Chanevan317/Mobile-Manipulator-Robot/README.md

# Mobile-Manipulator-Robot

A wheeled mobile manipulator for restocking retail shelves: a mecanum base, a C-Beam lift and 3D-printed SCARA
arms (STS3215 servos), with a small leader arm for teleoperation. Work in progress: the arms are being printed, and
the robot is tested in simulation (Isaac Sim, ROS 2).

robot

## Folders

| Folder | What |
|---|---|
| `CAD/SCARA_arm/` | the follower arm: print files, STEP, assembly, fastener lists |
| `CAD/dual_holder/` | two-arm robot: printed holder for both arm bases on the C-Beam carriage (and the scene camera post) |
| `CAD/mono_ring/` | shoulder ring for the one-arm version: the arm's own base on a shelf on the ring, 2 bought 6820-2RS bearings |
| `CAD/leader_arm/` | the leader arm for teleoperation |
| `CAD/lift_stick/` | one-hand controller for the lift: thumbstick, dead-man and stored-position buttons |
| `mobile_manipulator_description/` | the robot model (URDF, meshes), the CAD generator and the simulation scripts |

Large files (STL, STEP, PNG, ...) are stored with Git LFS: run `git lfs install` before cloning.
