Chanevan317/Mobile-Manipulator-Robot/CAD/lift_stick/parts.csv

file | qty | size_mm | volume_cm3 | note
S1_stick_tray.stl | 1 | 116.0 x 42.0 x 15.5 | 23.3 | bottom tray: the Pico slide-in mount (room for headers), holes for 2 optional M2 screws, USB opening, 4 countersunk M2.5 from underneath, 4 rubber-feet recesses; prints flat
S2_stick_top.stl | 1 | 116.0 x 42.0 x 34.0 | 26.6 | top shell (the grip): round stick hole + "up" arrow on the head, 4 posts for the joystick bracket, 2 button holes with guide sleeves + 2 bracket posts on the front, 2 fins that stop the Pico; prints upside down (head top on the bed, tree supports under the sloping tail)
S3_stick_bracket.stl | 1 | 44.0 x 28.0 x 5.4 | 2.6 | holds the joystick module (4 standoffs, M2.5 x 8 self-tap from above through its holes); screws up into the top shell (4 x M2 x 8); prints flat
S4_button_bracket.stl | 1 | 28.4 x 36.4 x 5.6 | 4.5 | OPTIONAL, print with the buttons: holds both 12 x 12 tactile switches (pockets to the front, leg slots behind); 2 x M2 x 10 into the posts on the front wall; prints on its back
S5_button_cap.stl | 2 | 12.9 x 26.8 x 9.2 | 2.3 | OPTIONAL, print 2 with the buttons: button cap, sticks out 3 mm; drop it in from inside before the bracket (the flange keeps it in); prints flange down
