Chanevan317/Mobile-Manipulator-Robot/CAD/SCARA_arm/fasteners_by_location.csv

# | goes in part | type | size | length_mm | purpose | x_part | y_part | z_part | dir_x | dir_y | dir_z | x_arm | y_arm | z_arm
1 | base_top | SHCS | M3 | 35 | clamshell | -41.50 | -16.30 | 29.00 | 0.000 | 0.000 | -1.000 | -41.50 | -16.30 | 29.00
2 | base_top | SHCS | M3 | 35 | clamshell | -41.50 | 16.30 | 29.00 | 0.000 | 0.000 | -1.000 | -41.50 | 16.30 | 29.00
3 | base_top | SHCS | M3 | 35 | clamshell | 27.81 | -14.79 | 29.00 | 0.000 | 0.000 | -1.000 | 27.81 | -14.79 | 29.00
4 | base_top | SHCS | M3 | 35 | clamshell | 27.81 | 14.79 | 29.00 | 0.000 | 0.000 | -1.000 | 27.81 | 14.79 | 29.00
5 | base_top | selftap | M2 | 6 | servo case (SO-100) | -32.80 | 10.25 | 17.90 | 0.000 | 0.000 | -1.000 | -32.80 | 10.25 | 17.90
6 | base_top | selftap | M2 | 6 | servo case (SO-100) | -32.80 | -10.25 | 17.90 | 0.000 | 0.000 | -1.000 | -32.80 | -10.25 | 17.90
7 | base_top | SHCS | M3 | 35 | clamshell | -74.00 | -14.50 | 29.00 | 0.000 | 0.000 | -1.000 | -74.00 | -14.50 | 29.00
8 | base_top | SHCS | M3 | 35 | clamshell | -74.00 | 14.50 | 29.00 | 0.000 | 0.000 | -1.000 | -74.00 | 14.50 | 29.00
9 | base_bottom | insert | M3 | 8 | clamshell | -41.50 | -16.30 | 0.00 | 0.000 | 0.000 | -1.000 | -41.50 | -16.30 | 0.00
10 | base_bottom | insert | M3 | 8 | clamshell | -41.50 | 16.30 | 0.00 | 0.000 | 0.000 | -1.000 | -41.50 | 16.30 | 0.00
11 | base_bottom | insert | M3 | 8 | clamshell | 27.81 | -14.79 | 0.00 | 0.000 | 0.000 | -1.000 | 27.81 | -14.79 | 0.00
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
112 | camera_cradle | selftap | M2 | 8 | camera board (from the front, into the standoff) | 106.14 | -14.00 | 112.29 | -0.819 | 0.000 | 0.574 | 406.14 | -14.00 | 37.69
113 | camera_cradle | selftap | M2 | 8 | camera board (from the front, into the standoff) | 90.08 | 14.00 | 89.35 | -0.819 | 0.000 | 0.574 | 390.08 | 14.00 | 14.75
114 | camera_cradle | selftap | M2 | 8 | camera board (from the front, into the standoff) | 106.14 | 14.00 | 112.29 | -0.819 | 0.000 | 0.574 | 406.14 | 14.00 | 37.69
115 | roll_yoke_gripper_housing | SHCS | M3 | 10 | roll horn | 25.60 | -4.95 | 4.95 | -1.000 | 0.000 | 0.000 | 410.60 | -4.95 | -69.65
116 | roll_yoke_gripper_housing | SHCS | M3 | 10 | roll horn | 25.60 | 4.95 | 4.95 | -1.000 | 0.000 | 0.000 | 410.60 | 4.95 | -69.65
117 | roll_yoke_gripper_housing | SHCS | M3 | 10 | roll horn | 25.60 | -4.95 | -4.95 | -1.000 | 0.000 | 0.000 | 410.60 | -4.95 | -79.55
118 | roll_yoke_gripper_housing | SHCS | M3 | 10 | roll horn | 25.60 | 4.95 | -4.95 | -1.000 | 0.000 | 0.000 | 410.60 | 4.95 | -79.55
119 | roll_yoke_gripper_housing | selftap | M2 | 6 | gripper servo case (SO-100) | 31.10 | -10.25 | 32.80 | 1.000 | 0.000 | 0.000 | 416.10 | -10.25 | -41.80
120 | roll_yoke_gripper_housing | selftap | M2 | 6 | gripper servo case (SO-100) | 31.10 | 10.25 | 32.80 | 1.000 | 0.000 | 0.000 | 416.10 | 10.25 | -41.80
121 | roll_yoke_gripper_housing | insert | M3 | 4 | gripper front plate | 66.00 | -16.10 | -8.00 | -1.000 | 0.000 | 0.000 | 451.00 | -16.10 | -82.60
122 | roll_yoke_gripper_housing | insert | M3 | 4 | gripper front plate | 66.00 | -16.10 | 30.00 | -1.000 | 0.000 | 0.000 | 451.00 | -16.10 | -44.60
123 | roll_yoke_gripper_housing | insert | M3 | 4 | gripper front plate | 66.00 | 16.10 | -8.00 | -1.000 | 0.000 | 0.000 | 451.00 | 16.10 | -82.60
124 | roll_yoke_gripper_housing | insert | M3 | 4 | gripper front plate | 66.00 | 16.10 | 30.00 | -1.000 | 0.000 | 0.000 | 451.00 | 16.10 | -44.60
125 | gripper_front_plate | SHCS | M3 | 10 | front plate to housing | 71.00 | -16.10 | -8.00 | -1.000 | 0.000 | 0.000 | 456.00 | -16.10 | -82.60
126 | gripper_front_plate | SHCS | M3 | 10 | front plate to housing | 71.00 | -16.10 | 30.00 | -1.000 | 0.000 | 0.000 | 456.00 | -16.10 | -44.60
127 | gripper_front_plate | SHCS | M3 | 10 | front plate to housing | 71.00 | 16.10 | -8.00 | -1.000 | 0.000 | 0.000 | 456.00 | 16.10 | -82.60
128 | gripper_front_plate | SHCS | M3 | 10 | front plate to housing | 71.00 | 16.10 | 30.00 | -1.000 | 0.000 | 0.000 | 456.00 | 16.10 | -44.60
129 | gripper_front_plate | SHCS | M3 | 12 | MGN9 rail | 77.00 | -80.00 | 32.00 | -1.000 | 0.000 | 0.000 | 462.00 | -80.00 | -42.60
130 | gripper_front_plate | nut | M3 |  | MGN9 rail (nut trap) | 66.00 | -80.00 | 32.00 | 1.000 | 0.000 | 0.000 | 451.00 | -80.00 | -42.60
131 | gripper_front_plate | SHCS | M3 | 12 | MGN9 rail | 77.00 | -60.00 | 32.00 | -1.000 | 0.000 | 0.000 | 462.00 | -60.00 | -42.60
132 | gripper_front_plate | nut | M3 |  | MGN9 rail (nut trap) | 66.00 | -60.00 | 32.00 | 1.000 | 0.000 | 0.000 | 451.00 | -60.00 | -42.60
133 | gripper_front_plate | SHCS | M3 | 12 | MGN9 rail | 77.00 | -40.00 | 32.00 | -1.000 | 0.000 | 0.000 | 462.00 | -40.00 | -42.60
134 | gripper_front_plate | nut | M3 |  | MGN9 rail (nut trap) | 66.00 | -40.00 | 32.00 | 1.000 | 0.000 | 0.000 | 451.00 | -40.00 | -42.60
135 | gripper_front_plate | SHCS | M3 | 12 | MGN9 rail | 77.00 | 40.00 | 32.00 | -1.000 | 0.000 | 0.000 | 462.00 | 40.00 | -42.60
136 | gripper_front_plate | nut | M3 |  | MGN9 rail (nut trap) | 66.00 | 40.00 | 32.00 | 1.000 | 0.000 | 0.000 | 451.00 | 40.00 | -42.60
137 | gripper_front_plate | SHCS | M3 | 12 | MGN9 rail | 77.00 | 60.00 | 32.00 | -1.000 | 0.000 | 0.000 | 462.00 | 60.00 | -42.60
138 | gripper_front_plate | nut | M3 |  | MGN9 rail (nut trap) | 66.00 | 60.00 | 32.00 | 1.000 | 0.000 | 0.000 | 451.00 | 60.00 | -42.60
139 | gripper_front_plate | SHCS | M3 | 12 | MGN9 rail | 77.00 | 80.00 | 32.00 | -1.000 | 0.000 | 0.000 | 462.00 | 80.00 | -42.60
140 | gripper_front_plate | nut | M3 |  | MGN9 rail (nut trap) | 66.00 | 80.00 | 32.00 | 1.000 | 0.000 | 0.000 | 451.00 | 80.00 | -42.60
141 | pinion_24T_m1 | SHCS | M3 | 10 | pinion to gripper horn | -4.95 | -4.95 | 75.60 | 0.000 | 0.000 | -1.000 | 460.60 | 1.00 | -81.53
142 | pinion_24T_m1 | SHCS | M3 | 10 | pinion to gripper horn | -4.95 | 4.95 | 75.60 | 0.000 | 0.000 | -1.000 | 460.60 | -6.93 | -75.60
143 | pinion_24T_m1 | SHCS | M3 | 10 | pinion to gripper horn | 4.95 | -4.95 | 75.60 | 0.000 | 0.000 | -1.000 | 460.60 | 6.93 | -73.60
144 | pinion_24T_m1 | SHCS | M3 | 10 | pinion to gripper horn | 4.95 | 4.95 | 75.60 | 0.000 | 0.000 | -1.000 | 460.60 | -1.00 | -67.67
145 | finger_carrier_right | SHCS | M3 | 8 | carrier to MGN9H | 89.00 | 12.50 | 24.50 | -1.000 | 0.000 | 0.000 | 474.00 | 42.50 | -50.10
146 | finger_carrier_right | SHCS | M3 | 8 | carrier to MGN9H | 89.00 | 12.50 | 39.50 | -1.000 | 0.000 | 0.000 | 474.00 | 42.50 | -35.10
147 | finger_carrier_right | SHCS | M3 | 8 | carrier to MGN9H | 89.00 | 28.50 | 24.50 | -1.000 | 0.000 | 0.000 | 474.00 | 58.50 | -50.10
148 | finger_carrier_right | SHCS | M3 | 8 | carrier to MGN9H | 89.00 | 28.50 | 39.50 | -1.000 | 0.000 | 0.000 | 474.00 | 58.50 | -35.10
149 | finger_carrier_right | SHCS | M3 | 10 | finger | 87.00 | 7.00 | -10.00 | 1.000 | 0.000 | 0.000 | 472.00 | 37.00 | -84.60
150 | finger_carrier_right | SHCS | M3 | 10 | finger | 87.00 | 7.00 | 10.00 | 1.000 | 0.000 | 0.000 | 472.00 | 37.00 | -64.60
151 | finger_carrier_left | SHCS | M3 | 8 | carrier to MGN9H | 89.00 | -12.50 | 24.50 | -1.000 | 0.000 | 0.000 | 474.00 | -42.50 | -50.10
152 | finger_carrier_left | SHCS | M3 | 8 | carrier to MGN9H | 89.00 | -12.50 | 39.50 | -1.000 | 0.000 | 0.000 | 474.00 | -42.50 | -35.10
153 | finger_carrier_left | SHCS | M3 | 8 | carrier to MGN9H | 89.00 | -28.50 | 24.50 | -1.000 | 0.000 | 0.000 | 474.00 | -58.50 | -50.10
154 | finger_carrier_left | SHCS | M3 | 8 | carrier to MGN9H | 89.00 | -28.50 | 39.50 | -1.000 | 0.000 | 0.000 | 474.00 | -58.50 | -35.10
155 | finger_carrier_left | SHCS | M3 | 10 | finger | 87.00 | -7.00 | -10.00 | 1.000 | 0.000 | 0.000 | 472.00 | -37.00 | -84.60
156 | finger_carrier_left | SHCS | M3 | 10 | finger | 87.00 | -7.00 | 10.00 | 1.000 | 0.000 | 0.000 | 472.00 | -37.00 | -64.60
157 | finger_right | insert | M3 | 6 | finger | 92.00 | 7.00 | -10.00 | 1.000 | 0.000 | 0.000 | 477.00 | 37.00 | -84.60
158 | finger_right | insert | M3 | 6 | finger | 92.00 | 7.00 | 10.00 | 1.000 | 0.000 | 0.000 | 477.00 | 37.00 | -64.60
159 | finger_left | insert | M3 | 6 | finger | 92.00 | -7.00 | -10.00 | 1.000 | 0.000 | 0.000 | 477.00 | -37.00 | -84.60
160 | finger_left | insert | M3 | 6 | finger | 92.00 | -7.00 | 10.00 | 1.000 | 0.000 | 0.000 | 477.00 | -37.00 | -64.60
