Chanevan317/Mobile-Manipulator-Robot/(list of files, cad)

Other CAD files:
CAD/SCARA_arm/SCARA_arm_assembly.3mf
CAD/SCARA_arm/step/SCARA_arm_printed_parts_assembly.step
CAD/dual_holder/assembly_stl/context/arm_bases_01_02.stl
CAD/dual_holder/assembly_stl/D01_holder_left.stl
CAD/dual_holder/print_ready_stl/D01_holder_left.stl
CAD/leader_arm/assembly_stl/mono/mono_foot.stl
CAD/leader_arm/assembly_stl/proto/L_S2_elbow.stl
CAD/leader_arm/print_ready_stl/03_link2.stl
CAD/lift_stick/assembly_stl/S2_stick_top.stl
CAD/lift_stick/print_ready_stl/S5_button_cap.stl
CAD/mono_ring/assembly_stl/context/arm_base_01_02_with_shoulder_servo.stl
CAD/mono_ring/assembly_stl/M04_gantry_bracket.stl
CAD/mono_ring/print_ready_stl/M08_board_mount.stl
CAD/SCARA_arm/assembly_stl/14_roll_yoke_gripper_housing.stl
CAD/SCARA_arm/print_ready_stl/14_roll_yoke_gripper_housing.stl
CAD/SCARA_arm/SO100/WaveShare_Mounting_Plate_SO101.stl
mobile_manipulator_description/generator/cbeam/carriage.stl
mobile_manipulator_description/generator/sts3215_03a_v1.stl
mobile_manipulator_description/meshes/collision/dual_holder_right_c31.stl
mobile_manipulator_description/meshes/visual/dual_holder_left.stl
CAD/dual_holder/assembly_stl/context/camera_post.stl
CAD/dual_holder/assembly_stl/D02_holder_right.stl
CAD/dual_holder/print_ready_stl/D02_holder_right.stl
CAD/leader_arm/assembly_stl/mono/pedestal.stl
CAD/leader_arm/assembly_stl/proto/R_pedestal.stl
CAD/leader_arm/print_ready_stl/08_gripper_jaw.stl
CAD/lift_stick/assembly_stl/S3_stick_bracket.stl
CAD/lift_stick/print_ready_stl/S3_stick_bracket.stl
CAD/mono_ring/assembly_stl/context/bearings_61820.stl
CAD/mono_ring/assembly_stl/M01_ring_base.stl
CAD/mono_ring/print_ready_stl/M02_inner_spacer.stl
CAD/SCARA_arm/assembly_stl/17_finger_carrier_right.stl
CAD/SCARA_arm/print_ready_stl/22_insert_test_block.stl
CAD/SCARA_arm/SO100/Print_Leader_SO_ARM100_08k_UP_BambuLabA1Mini_part1.STL
CAD/SCARA_arm/step/SCARA_arm_purchased_parts.step
mobile_manipulator_description/generator/cbeam/column_hw.stl
mobile_manipulator_description/meshes/collision/dual_holder_left_c13.stl
mobile_manipulator_description/meshes/visual/dual_holder_right.stl
CAD/dual_holder/assembly_stl/context/lift_kit_gantry_wheels_beam.stl
CAD/leader_arm/assembly_stl/mono/pitch_fork.stl
CAD/leader_arm/assembly_stl/proto/L_pedestal.stl
CAD/leader_arm/print_ready_stl/11_proto_foot_left.stl
CAD/lift_stick/assembly_stl/S4_button_bracket.stl
CAD/lift_stick/print_ready_stl/S4_button_bracket.stl
CAD/mono_ring/assembly_stl/context/drive_servo_STS3215.stl
CAD/mono_ring/assembly_stl/M10_cable_tray.stl
CAD/mono_ring/print_ready_stl/M03_clamp_ring.stl
CAD/SCARA_arm/assembly_stl/12_tilt_fork_idler.stl
CAD/SCARA_arm/print_ready_stl/16_pinion_24T_m1.stl
CAD/SCARA_arm/SO100/Print_Leader_SO_ARM100_08k_UP_BambuLabA1Mini_part2.STL
mobile_manipulator_description/generator/cbeam/motor.stl
mobile_manipulator_description/meshes/collision/dual_holder_left_c42.stl
mobile_manipulator_description/meshes/visual/mono_bearing_2_inner.stl
CAD/leader_arm/assembly_stl/mono/link2.stl
CAD/leader_arm/assembly_stl/proto/R_S4_pitch.stl
CAD/leader_arm/print_ready_stl/05_pitch_fork.stl
CAD/lift_stick/assembly_stl/S5_button_cap.stl
CAD/lift_stick/print_ready_stl/S2_stick_top.stl
CAD/mono_ring/assembly_stl/context/servo_board_on_SO101_plate.stl
CAD/mono_ring/assembly_stl/M08_board_mount.stl
CAD/mono_ring/print_ready_stl/M04_gantry_bracket.stl
CAD/SCARA_arm/assembly_stl/20_finger_left.stl
CAD/SCARA_arm/print_ready_stl/04_upper_arm_bottom.stl
mobile_manipulator_description/generator/cbeam/top.stl
mobile_manipulator_description/meshes/collision/dual_holder_right_c08.stl
mobile_manipulator_description/meshes/visual/mono_servo_board.stl
CAD/leader_arm/assembly_stl/mono/wrist.stl
CAD/leader_arm/assembly_stl/proto/R_shoulder_mount.stl
CAD/leader_arm/print_ready_stl/10_mono_foot.stl
CAD/lift_stick/assembly_stl/boards_assumed.stl
CAD/lift_stick/print_ready_stl/S1_stick_tray.stl
CAD/mono_ring/assembly_stl/M03_clamp_ring.stl
CAD/mono_ring/print_ready_stl/M01_ring_base.stl
CAD/SCARA_arm/assembly_stl/01_base_top.stl
CAD/SCARA_arm/print_ready_stl/17_finger_carrier_right.stl
mobile_manipulator_description/generator/cbeam/beam.stl
mobile_manipulator_description/meshes/collision/dual_holder_right_c57.stl
mobile_manipulator_description/meshes/visual/mono_bearing_2_outer.stl
CAD/leader_arm/assembly_stl/mono/gripper_fixed_jaw.stl
CAD/leader_arm/assembly_stl/proto/L_S4_pitch.stl
CAD/leader_arm/print_ready_stl/07_gripper_fixed_jaw.stl
CAD/lift_stick/assembly_stl/S1_stick_tray.stl
CAD/mono_ring/assembly_stl/M02_inner_spacer.stl
CAD/mono_ring/print_ready_stl/M10_cable_tray.stl
CAD/SCARA_arm/assembly_stl/06_forearm_bottom.stl
CAD/SCARA_arm/print_ready_stl/13_camera_cradle.stl
mobile_manipulator_description/meshes/collision/dual_holder_right_c18.stl
mobile_manipulator_description/meshes/visual/mono_ring_base.stl
CAD/leader_arm/assembly_stl/mono/S5_roll.stl
CAD/leader_arm/assembly_stl/proto/L_S6_gripper.stl
CAD/leader_arm/print_ready_stl/04_wrist.stl
CAD/mono_ring/assembly_stl/M09_rotor.stl
CAD/mono_ring/print_ready_stl/M09_rotor.stl
CAD/SCARA_arm/assembly_stl/05_forearm_top.stl
CAD/SCARA_arm/print_ready_stl/01_base_top.stl
mobile_manipulator_description/meshes/collision/dual_holder_right_c35.stl
mobile_manipulator_description/meshes/visual/mono_ring_drive_STS3215.stl
CAD/leader_arm/assembly_stl/mono/S4_pitch.stl
CAD/leader_arm/assembly_stl/proto/R_gripper_frame.stl
CAD/leader_arm/print_ready_stl/09_pedestal.stl
CAD/mono_ring/assembly_stl/M06_drive_strap.stl
CAD/mono_ring/print_ready_stl/M07_ring_pinion.stl
CAD/SCARA_arm/assembly_stl/10_pitch_housing_idler.stl
CAD/SCARA_arm/print_ready_stl/03_upper_arm_top.stl
mobile_manipulator_description/meshes/collision/dual_holder_right_c24.stl
mobile_manipulator_description/meshes/visual/mono_rotor.stl
CAD/leader_arm/assembly_stl/mono/S2_elbow.stl
CAD/leader_arm/assembly_stl/proto/L_gripper_jaw.stl
CAD/leader_arm/print_ready_stl/02_link1.stl
CAD/mono_ring/assembly_stl/M05_drive_mount.stl
CAD/mono_ring/print_ready_stl/M05_drive_mount.stl
CAD/SCARA_arm/assembly_stl/18_finger_carrier_left.stl
CAD/SCARA_arm/print_ready_stl/10_pitch_housing_idler.stl
mobile_manipulator_description/meshes/collision/dual_holder_right_c49.stl
mobile_manipulator_description/meshes/visual/mono_board_mount.stl
CAD/leader_arm/assembly_stl/mono/S3_wrist_pan.stl
CAD/leader_arm/assembly_stl/proto/L_wrist.stl
CAD/leader_arm/print_ready_stl/01_shoulder_mount.stl
CAD/mono_ring/assembly_stl/M07_ring_pinion.stl
CAD/mono_ring/print_ready_stl/M06_drive_strap.stl
CAD/SCARA_arm/assembly_stl/07_wrist_top.stl
CAD/SCARA_arm/print_ready_stl/12_tilt_fork_idler.stl
mobile_manipulator_description/meshes/collision/dual_holder_left_c29.stl
mobile_manipulator_description/meshes/visual/arm_roll_yoke_gripper_housing.stl
CAD/leader_arm/assembly_stl/mono/shoulder_mount.stl
CAD/leader_arm/assembly_stl/proto/L_S3_wrist_pan.stl
CAD/leader_arm/print_ready_stl/12_proto_foot_right.stl
CAD/SCARA_arm/assembly_stl/19_finger_right.stl
CAD/SCARA_arm/print_ready_stl/19_finger_right.stl
mobile_manipulator_description/meshes/collision/dual_holder_right_c21.stl
mobile_manipulator_description/meshes/visual/mono_drive_strap.stl
CAD/leader_arm/assembly_stl/mono/gripper_jaw.stl
CAD/leader_arm/assembly_stl/proto/R_gripper_fixed_jaw.stl
CAD/leader_arm/print_ready_stl/06_gripper_frame.stl
CAD/SCARA_arm/assembly_stl/08_wrist_bottom.stl
CAD/SCARA_arm/print_ready_stl/08_wrist_bottom.stl
mobile_manipulator_description/meshes/collision/dual_holder_right_c27.stl
mobile_manipulator_description/meshes/visual/mono_drive_mount.stl
CAD/leader_arm/assembly_stl/mono/S6_gripper.stl
CAD/leader_arm/assembly_stl/proto/proto_foot_left.stl
CAD/SCARA_arm/assembly_stl/03_upper_arm_top.stl
CAD/SCARA_arm/print_ready_stl/02_base_bottom.stl
mobile_manipulator_description/meshes/collision/dual_holder_right_c52.stl
mobile_manipulator_description/meshes/visual/mono_cable_tray.stl
CAD/leader_arm/assembly_stl/mono/S1_shoulder.stl
CAD/leader_arm/assembly_stl/proto/L_S1_shoulder.stl
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
