Chanevan317/Mobile-Manipulator-Robot/mobile_manipulator_description/joint_test_report.csv

joint | unit | limit_lo | limit_hi | reached_lo | reached_hi | max_tracking_error | final_error | status
lift | mm | 0.0 | 871.0 | 0.0 | 870.5 | 1.53 | 0.0 | OK
left_shoulder_pan | deg | -115.0 | 115.0 | -115.0 | 115.0 | 6.87 | 0.07 | OK
right_shoulder_pan | deg | -115.0 | 115.0 | -115.0 | 115.0 | 6.87 | 0.07 | OK
left_elbow_pan | deg | -125.0 | 125.0 | -125.0 | 125.0 | 7.27 | 0.05 | OK
right_elbow_pan | deg | -125.0 | 125.0 | -125.0 | 125.0 | 7.27 | 0.05 | OK
left_wrist_pan | deg | -122.0 | 122.0 | -122.0 | 122.0 | 7.04 | 0.01 | OK
right_wrist_pan | deg | -122.0 | 122.0 | -122.0 | 122.0 | 7.04 | 0.01 | OK
left_wrist_pitch | deg | -15.0 | 115.0 | -13.3 | 114.6 | 5.11 | 1.81 | OK
right_wrist_pitch | deg | -15.0 | 115.0 | -13.3 | 114.6 | 5.11 | 1.81 | OK
left_wrist_roll | deg | -120.0 | 120.0 | -120.0 | 120.0 | 7.02 | 0.0 | OK
right_wrist_roll | deg | -120.0 | 120.0 | -120.0 | 120.0 | 7.02 | 0.0 | OK
left_finger_right | mm | 0.0 | 45.0 | 0.0 | 45.0 | 1.89 | 0.0 | OK
right_finger_right | mm | 0.0 | 45.0 | 0.0 | 45.0 | 1.89 | 0.0 | OK
