Chanevan317/Mobile-Manipulator-Robot/mobile_manipulator_description/reach_test_prototype.csv

surface | height_m | x_m | y_m | left | right
table | 0.75 | 0.315 | -0.45 | 0 | 0
table | 0.75 | 0.315 | -0.42 | 0 | 0
table | 0.75 | 0.315 | -0.39 | 0 | 1
table | 0.75 | 0.315 | -0.36 | 0 | 1
table | 0.75 | 0.315 | -0.33 | 0 | 1
table | 0.75 | 0.315 | -0.3 | 0 | 1
table | 0.75 | 0.315 | -0.27 | 0 | 1
table | 0.75 | 0.315 | -0.24 | 0 | 1
table | 0.75 | 0.315 | -0.21 | 0 | 1
table | 0.75 | 0.315 | -0.18 | 0 | 1
table | 0.75 | 0.315 | -0.15 | 0 | 1
table | 0.75 | 0.315 | -0.12 | 0 | 1
table | 0.75 | 0.315 | -0.09 | 0 | 1
table | 0.75 | 0.315 | -0.06 | 0 | 1
table | 0.75 | 0.315 | -0.03 | 0 | 0
table | 0.75 | 0.315 | -0.0 | 0 | 0
table | 0.75 | 0.315 | 0.03 | 0 | 0
table | 0.75 | 0.315 | 0.06 | 1 | 0
table | 0.75 | 0.315 | 0.09 | 1 | 0
table | 0.75 | 0.315 | 0.12 | 1 | 0
table | 0.75 | 0.315 | 0.15 | 1 | 0
table | 0.75 | 0.315 | 0.18 | 1 | 0
table | 0.75 | 0.315 | 0.21 | 1 | 0
table | 0.75 | 0.315 | 0.24 | 1 | 0
table | 0.75 | 0.315 | 0.27 | 1 | 0
table | 0.75 | 0.315 | 0.3 | 1 | 0
table | 0.75 | 0.315 | 0.33 | 1 | 0
table | 0.75 | 0.315 | 0.36 | 1 | 0
table | 0.75 | 0.315 | 0.39 | 1 | 0
table | 0.75 | 0.315 | 0.42 | 0 | 0
table | 0.75 | 0.315 | 0.45 | 0 | 0
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
