Chanevan317/Mobile-Manipulator-Robot/mobile_manipulator_description/urdf/mobile_manipulator_prototype.urdf

<?xml version="1.0" encoding="utf-8"?>
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
<robot name="mobile_manipulator">
  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
  <link name="base_link">
    <inertial><origin xyz="0 0 0" rpy="0 0 0"/><mass value="0.001"/>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</inertial>
  </link>
  <link name="base_body">
    <inertial><origin xyz="0 0 0.113947" rpy="0 0 0"/><mass value="19"/>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</inertial>
    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
  </link>
  <joint name="base_body_fixed" type="fixed"><parent link="base_link"/><child link="base_body"/><origin xyz="0 0 0" rpy="0 0 0"/></joint>
  <link name="wheel_fl">
    <inertial><origin xyz="0 0 0" rpy="0 0 0"/><mass value="0.3"/>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</inertial>
    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
  </link>
  <joint name="wheel_fl_joint" type="continuous"><parent link="base_link"/><child link="wheel_fl"/><origin xyz="0.17 0.222 0.05" rpy="0 0 0"/><axis xyz="0 1 0"/><limit lower="-1e+09" upper="1e+09" effort="6" velocity="25"/><dynamics damping="0.1" friction="0.05"/></joint>
  <link name="wheel_fl_roller_0">
    <inertial><origin xyz="0 0 0" rpy="0 0 0"/><mass value="0.012"/>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</inertial>
    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
  </link>
  <joint name="wheel_fl_roller_0_joint" type="continuous"><parent link="wheel_fl"/><child link="wheel_fl_roller_0"/><origin xyz="0 0 0.039" rpy="-1.5708 0.785398 -0.785398"/><axis xyz="0 0 1"/><limit lower="-1e+09" upper="1e+09" effort="0" velocity="200"/><dynamics damping="0.0005" friction="0"/></joint>
  <link name="wheel_fl_roller_1">
    <inertial><origin xyz="0 0 0" rpy="0 0 0"/><mass value="0.012"/>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</inertial>
    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
  </link>
  <joint name="wheel_fl_roller_1_joint" type="continuous"><parent link="wheel_fl"/><child link="wheel_fl_roller_1"/><origin xyz="0.0250687 0 0.0298757" rpy="-2.14208 0.572429 -0.988745"/><axis xyz="0 0 1"/><limit lower="-1e+09" upper="1e+09" effort="0" velocity="200"/><dynamics damping="0.0005" friction="0"/></joint>
  <link name="wheel_fl_roller_2">
    <inertial><origin xyz="0 0 0" rpy="0 0 0"/><mass value="0.012"/>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</inertial>
    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
  </link>
  <joint name="wheel_fl_roller_2_joint" type="continuous"><parent link="wheel_fl"/><child link="wheel_fl_roller_2"/><origin xyz="0.0384075 0 0.00677228" rpy="-2.34854 0.123098 -0.292272"/><axis xyz="0 0 1"/><limit lower="-1e+09" upper="1e+09" effort="0" velocity="200"/><dynamics damping="0.0005" friction="0"/></joint>
  <link name="wheel_fl_roller_3">
    <inertial><origin xyz="0 0 0" rpy="0 0 0"/><mass value="0.012"/>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</inertial>
    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
  </link>
  <joint name="wheel_fl_roller_3_joint" type="continuous"><parent link="wheel_fl"/><child link="wheel_fl_roller_3"/><origin xyz="0.033775 0 -0.0195" rpy="-2.28452 -0.361367 0.76077"/><axis xyz="0 0 1"/><limit lower="-1e+09" upper="1e+09" effort="0" velocity="200"/><dynamics damping="0.0005" friction="0"/></joint>
  <link name="wheel_fl_roller_4">
    <inertial><origin xyz="0 0 0" rpy="0 0 0"/><mass value="0.012"/>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</inertial>
    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
  </link>
  <joint name="wheel_fl_roller_4_joint" type="continuous"><parent link="wheel_fl"/><child link="wheel_fl_roller_4"/><origin xyz="0.0133388 0 -0.036648" rpy="-1.90034 -0.726775 0.977781"/><axis xyz="0 0 1"/><limit lower="-1e+09" upper="1e+09" effort="0" velocity="200"/><dynamics damping="0.0005" friction="0"/></joint>
  <link name="wheel_fl_roller_5">
    <inertial><origin xyz="0 0 0" rpy="0 0 0"/><mass value="0.012"/>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</inertial>
    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
  </link>
  <joint name="wheel_fl_roller_5_joint" type="continuous"><parent link="wheel_fl"/><child link="wheel_fl_roller_5"/><origin xyz="-0.0133388 0 -0.036648" rpy="-1.24125 -0.726775 0.530853"/><axis xyz="0 0 1"/><limit lower="-1e+09" upper="1e+09" effort="0" velocity="200"/><dynamics damping="0.0005" friction="0"/></joint>
  <link name="wheel_fl_roller_6">
    <inertial><origin xyz="0 0 0" rpy="0 0 0"/><mass value="0.012"/>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</inertial>
    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
  </link>
  <joint name="wheel_fl_roller_6_joint" type="continuous"><parent link="wheel_fl"/><child link="wheel_fl_roller_6"/><origin xyz="-0.033775 0 -0.0195" rpy="-0.857072 -0.361367 0.166525"/><axis xyz="0 0 1"/><limit lower="-1e+09" upper="1e+09" effort="0" velocity="200"/><dynamics damping="0.0005" friction="0"/></joint>
  <link name="wheel_fl_roller_7">
    <inertial><origin xyz="0 0 0" rpy="0 0 0"/><mass value="0.012"/>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</inertial>
    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
  </link>
  <joint name="wheel_fl_roller_7_joint" type="continuous"><parent link="wheel_fl"/><child link="wheel_fl_roller_7"/><origin xyz="-0.0384075 0 0.00677228" rpy="-0.793052 0.123098 -0.0515956"/><axis xyz="0 0 1"/><limit lower="-1e+09" upper="1e+09" effort="0" velocity="200"/><dynamics damping="0.0005" friction="0"/></joint>
  <link name="wheel_fl_roller_8">
    <inertial><origin xyz="0 0 0" rpy="0 0 0"/><mass value="0.012"/>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</inertial>
    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
  </link>
  <joint name="wheel_fl_roller_8_joint" type="continuous"><parent link="wheel_fl"/><child link="wheel_fl_roller_8"/><origin xyz="-0.0250687 0 0.0298757" rpy="-0.999508 0.572429 -0.318636"/><axis xyz="0 0 1"/><limit lower="-1e+09" upper="1e+09" effort="0" velocity="200"/><dynamics damping="0.0005" friction="0"/></joint>
  <link name="wheel_fr">
    <inertial><origin xyz="0 0 0" rpy="0 0 0"/><mass value="0.3"/>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</inertial>
    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
  </link>
  <joint name="wheel_fr_joint" type="continuous"><parent link="base_link"/><child link="wheel_fr"/><origin xyz="0.17 -0.222 0.05" rpy="0 0 0"/><axis xyz="0 1 0"/><limit lower="-1e+09" upper="1e+09" effort="6" velocity="25"/><dynamics damping="0.1" friction="0.05"/></joint>
  <link name="wheel_fr_roller_0">
    <inertial><origin xyz="0 0 0" rpy="0 0 0"/><mass value="0.012"/>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</inertial>
    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
  </link>
  <joint name="wheel_fr_roller_0_joint" type="continuous"><parent link="wheel_fr"/><child link="wheel_fr_roller_0"/><origin xyz="0 0 0.039" rpy="-1.5708 -0.785398 0.785398"/><axis xyz="0 0 1"/><limit lower="-1e+09" upper="1e+09" effort="0" velocity="200"/><dynamics damping="0.0005" friction="0"/></joint>
  <link name="wheel_fr_roller_1">
    <inertial><origin xyz="0 0 0" rpy="0 0 0"/><mass value="0.012"/>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</inertial>
    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
  </link>
  <joint name="wheel_fr_roller_1_joint" type="continuous"><parent link="wheel_fr"/><child link="wheel_fr_roller_1"/><origin xyz="0.0250687 0 0.0298757" rpy="-0.999508 -0.572429 0.318636"/><axis xyz="0 0 1"/><limit lower="-1e+09" upper="1e+09" effort="0" velocity="200"/><dynamics damping="0.0005" friction="0"/></joint>
  <link name="wheel_fr_roller_2">
    <inertial><origin xyz="0 0 0" rpy="0 0 0"/><mass value="0.012"/>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</inertial>
    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
  </link>
  <joint name="wheel_fr_roller_2_joint" type="continuous"><parent link="wheel_fr"/><child link="wheel_fr_roller_2"/><origin xyz="0.0384075 0 0.00677228" rpy="-0.793052 -0.123098 0.0515956"/><axis xyz="0 0 1"/><limit lower="-1e+09" upper="1e+09" effort="0" velocity="200"/><dynamics damping="0.0005" friction="0"/></joint>
  <link name="wheel_fr_roller_3">
    <inertial><origin xyz="0 0 0" rpy="0 0 0"/><mass value="0.012"/>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</inertial>
    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
  </link>
  <joint name="wheel_fr_roller_3_joint" type="continuous"><parent link="wheel_fr"/><child link="wheel_fr_roller_3"/><origin xyz="0.033775 0 -0.0195" rpy="-0.857072 0.361367 -0.166525"/><axis xyz="0 0 1"/><limit lower="-1e+09" upper="1e+09" effort="0" velocity="200"/><dynamics damping="0.0005" friction="0"/></joint>
  <link name="wheel_fr_roller_4">
    <inertial><origin xyz="0 0 0" rpy="0 0 0"/><mass value="0.012"/>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</inertial>
    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
  </link>
  <joint name="wheel_fr_roller_4_joint" type="continuous"><parent link="wheel_fr"/><child link="wheel_fr_roller_4"/><origin xyz="0.0133388 0 -0.036648" rpy="-1.24125 0.726775 -0.530853"/><axis xyz="0 0 1"/><limit lower="-1e+09" upper="1e+09" effort="0" velocity="200"/><dynamics damping="0.0005" friction="0"/></joint>
  <link name="wheel_fr_roller_5">
    <inertial><origin xyz="0 0 0" rpy="0 0 0"/><mass value="0.012"/>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</inertial>
    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
  </link>
  <joint name="wheel_fr_roller_5_joint" type="continuous"><parent link="wheel_fr"/><child link="wheel_fr_roller_5"/><origin xyz="-0.0133388 0 -0.036648" rpy="-1.90034 0.726775 -0.977781"/><axis xyz="0 0 1"/><limit lower="-1e+09" upper="1e+09" effort="0" velocity="200"/><dynamics damping="0.0005" friction="0"/></joint>
  <link name="wheel_fr_roller_6">
    <inertial><origin xyz="0 0 0" rpy="0 0 0"/><mass value="0.012"/>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</inertial>
    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
  </link>
  <joint name="wheel_fr_roller_6_joint" type="continuous"><parent link="wheel_fr"/><child link="wheel_fr_roller_6"/><origin xyz="-0.033775 0 -0.0195" rpy="-2.28452 0.361367 -0.76077"/><axis xyz="0 0 1"/><limit lower="-1e+09" upper="1e+09" effort="0" velocity="200"/><dynamics damping="0.0005" friction="0"/></joint>
  <link name="wheel_fr_roller_7">
    <inertial><origin xyz="0 0 0" rpy="0 0 0"/><mass value="0.012"/>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</inertial>
    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
  </link>
  <joint name="wheel_fr_roller_7_joint" type="continuous"><parent link="wheel_fr"/><child link="wheel_fr_roller_7"/><origin xyz="-0.0384075 0 0.00677228" rpy="-2.34854 -0.123098 0.292272"/><axis xyz="0 0 1"/><limit lower="-1e+09" upper="1e+09" effort="0" velocity="200"/><dynamics damping="0.0005" friction="0"/></joint>
  <link name="wheel_fr_roller_8">
    <inertial><origin xyz="0 0 0" rpy="0 0 0"/><mass value="0.012"/>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</inertial>
    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
  </link>
  <joint name="wheel_fr_roller_8_joint" type="continuous"><parent link="wheel_fr"/><child link="wheel_fr_roller_8"/><origin xyz="-0.0250687 0 0.0298757" rpy="-2.14208 -0.572429 0.988745"/><axis xyz="0 0 1"/><limit lower="-1e+09" upper="1e+09" effort="0" velocity="200"/><dynamics damping="0.0005" friction="0"/></joint>
  <link name="wheel_rl">
    <inertial><origin xyz="0 0 0" rpy="0 0 0"/><mass value="0.3"/>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</inertial>
    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
  </link>
  <joint name="wheel_rl_joint" type="continuous"><parent link="base_link"/><child link="wheel_rl"/><origin xyz="-0.17 0.222 0.05" rpy="0 0 0"/><axis xyz="0 1 0"/><limit lower="-1e+09" upper="1e+09" effort="6" velocity="25"/><dynamics damping="0.1" friction="0.05"/></joint>
  <link name="wheel_rl_roller_0">
    <inertial><origin xyz="0 0 0" rpy="0 0 0"/><mass value="0.012"/>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</inertial>
    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
  </link>
  <joint name="wheel_rl_roller_0_joint" type="continuous"><parent link="wheel_rl"/><child link="wheel_rl_roller_0"/><origin xyz="0 0 0.039" rpy="-1.5708 -0.785398 0.785398"/><axis xyz="0 0 1"/><limit lower="-1e+09" upper="1e+09" effort="0" velocity="200"/><dynamics damping="0.0005" friction="0"/></joint>
  <link name="wheel_rl_roller_1">
    <inertial><origin xyz="0 0 0" rpy="0 0 0"/><mass value="0.012"/>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</inertial>
    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
  </link>
  <joint name="wheel_rl_roller_1_joint" type="continuous"><parent link="wheel_rl"/><child link="wheel_rl_roller_1"/><origin xyz="0.0250687 0 0.0298757" rpy="-0.999508 -0.572429 0.318636"/><axis xyz="0 0 1"/><limit lower="-1e+09" upper="1e+09" effort="0" velocity="200"/><dynamics damping="0.0005" friction="0"/></joint>
  <link name="wheel_rl_roller_2">
    <inertial><origin xyz="0 0 0" rpy="0 0 0"/><mass value="0.012"/>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</inertial>
    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
  </link>
  <joint name="wheel_rl_roller_2_joint" type="continuous"><parent link="wheel_rl"/><child link="wheel_rl_roller_2"/><origin xyz="0.0384075 0 0.00677228" rpy="-0.793052 -0.123098 0.0515956"/><axis xyz="0 0 1"/><limit lower="-1e+09" upper="1e+09" effort="0" velocity="200"/><dynamics damping="0.0005" friction="0"/></joint>
  <link name="wheel_rl_roller_3">
    <inertial><origin xyz="0 0 0" rpy="0 0 0"/><mass value="0.012"/>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</inertial>
    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
  </link>
  <joint name="wheel_rl_roller_3_joint" type="continuous"><parent link="wheel_rl"/><child link="wheel_rl_roller_3"/><origin xyz="0.033775 0 -0.0195" rpy="-0.857072 0.361367 -0.166525"/><axis xyz="0 0 1"/><limit lower="-1e+09" upper="1e+09" effort="0" velocity="200"/><dynamics damping="0.0005" friction="0"/></joint>
  <link name="wheel_rl_roller_4">
    <inertial><origin xyz="0 0 0" rpy="0 0 0"/><mass value="0.012"/>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</inertial>
    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
  </link>
  <joint name="wheel_rl_roller_4_joint" type="continuous"><parent link="wheel_rl"/><child link="wheel_rl_roller_4"/><origin xyz="0.0133388 0 -0.036648" rpy="-1.24125 0.726775 -0.530853"/><axis xyz="0 0 1"/><limit lower="-1e+09" upper="1e+09" effort="0" velocity="200"/><dynamics damping="0.0005" friction="0"/></joint>
  <link name="wheel_rl_roller_5">
    <inertial><origin xyz="0 0 0" rpy="0 0 0"/><mass value="0.012"/>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</inertial>
    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
  </link>
  <joint name="wheel_rl_roller_5_joint" type="continuous"><parent link="wheel_rl"/><child link="wheel_rl_roller_5"/><origin xyz="-0.0133388 0 -0.036648" rpy="-1.90034 0.726775 -0.977781"/><axis xyz="0 0 1"/><limit lower="-1e+09" upper="1e+09" effort="0" velocity="200"/><dynamics damping="0.0005" friction="0"/></joint>
  <link name="wheel_rl_roller_6">
    <inertial><origin xyz="0 0 0" rpy="0 0 0"/><mass value="0.012"/>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</inertial>
    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
  </link>
  <joint name="wheel_rl_roller_6_joint" type="continuous"><parent link="wheel_rl"/><child link="wheel_rl_roller_6"/><origin xyz="-0.033775 0 -0.0195" rpy="-2.28452 0.361367 -0.76077"/><axis xyz="0 0 1"/><limit lower="-1e+09" upper="1e+09" effort="0" velocity="200"/><dynamics damping="0.0005" friction="0"/></joint>
  <link name="wheel_rl_roller_7">
    <inertial><origin xyz="0 0 0" rpy="0 0 0"/><mass value="0.012"/>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</inertial>
    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
  </link>
  <joint name="wheel_rl_roller_7_joint" type="continuous"><parent link="wheel_rl"/><child link="wheel_rl_roller_7"/><origin xyz="-0.0384075 0 0.00677228" rpy="-2.34854 -0.123098 0.292272"/><axis xyz="0 0 1"/><limit lower="-1e+09" upper="1e+09" effort="0" velocity="200"/><dynamics damping="0.0005" friction="0"/></joint>
  <link name="wheel_rl_roller_8">
    <inertial><origin xyz="0 0 0" rpy="0 0 0"/><mass value="0.012"/>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</inertial>
    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
  </link>
  <joint name="wheel_rl_roller_8_joint" type="continuous"><parent link="wheel_rl"/><child link="wheel_rl_roller_8"/><origin xyz="-0.0250687 0 0.0298757" rpy="-2.14208 -0.572429 0.988745"/><axis xyz="0 0 1"/><limit lower="-1e+09" upper="1e+09" effort="0" velocity="200"/><dynamics damping="0.0005" friction="0"/></joint>
  <link name="wheel_rr">
    <inertial><origin xyz="0 0 0" rpy="0 0 0"/><mass value="0.3"/>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</inertial>
    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
  </link>
  <joint name="wheel_rr_joint" type="continuous"><parent link="base_link"/><child link="wheel_rr"/><origin xyz="-0.17 -0.222 0.05" rpy="0 0 0"/><axis xyz="0 1 0"/><limit lower="-1e+09" upper="1e+09" effort="6" velocity="25"/><dynamics damping="0.1" friction="0.05"/></joint>
  <link name="wheel_rr_roller_0">
    <inertial><origin xyz="0 0 0" rpy="0 0 0"/><mass value="0.012"/>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</inertial>
    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
  </link>
  <joint name="wheel_rr_roller_0_joint" type="continuous"><parent link="wheel_rr"/><child link="wheel_rr_roller_0"/><origin xyz="0 0 0.039" rpy="-1.5708 0.785398 -0.785398"/><axis xyz="0 0 1"/><limit lower="-1e+09" upper="1e+09" effort="0" velocity="200"/><dynamics damping="0.0005" friction="0"/></joint>
  <link name="wheel_rr_roller_1">
    <inertial><origin xyz="0 0 0" rpy="0 0 0"/><mass value="0.012"/>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</inertial>
    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
  </link>
  <joint name="wheel_rr_roller_1_joint" type="continuous"><parent link="wheel_rr"/><child link="wheel_rr_roller_1"/><origin xyz="0.0250687 0 0.0298757" rpy="-2.14208 0.572429 -0.988745"/><axis xyz="0 0 1"/><limit lower="-1e+09" upper="1e+09" effort="0" velocity="200"/><dynamics damping="0.0005" friction="0"/></joint>
  <link name="wheel_rr_roller_2">
    <inertial><origin xyz="0 0 0" rpy="0 0 0"/><mass value="0.012"/>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</inertial>
    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
  </link>
  <joint name="wheel_rr_roller_2_joint" type="continuous"><parent link="wheel_rr"/><child link="wheel_rr_roller_2"/><origin xyz="0.0384075 0 0.00677228" rpy="-2.34854 0.123098 -0.292272"/><axis xyz="0 0 1"/><limit lower="-1e+09" upper="1e+09" effort="0" velocity="200"/><dynamics damping="0.0005" friction="0"/></joint>
  <link name="wheel_rr_roller_3">
    <inertial><origin xyz="0 0 0" rpy="0 0 0"/><mass value="0.012"/>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</inertial>
    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
  </link>
  <joint name="wheel_rr_roller_3_joint" type="continuous"><parent link="wheel_rr"/><child link="wheel_rr_roller_3"/><origin xyz="0.033775 0 -0.0195" rpy="-2.28452 -0.361367 0.76077"/><axis xyz="0 0 1"/><limit lower="-1e+09" upper="1e+09" effort="0" velocity="200"/><dynamics damping="0.0005" friction="0"/></joint>
  <link name="wheel_rr_roller_4">
    <inertial><origin xyz="0 0 0" rpy="0 0 0"/><mass value="0.012"/>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</inertial>
    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
  </link>
  <joint name="wheel_rr_roller_4_joint" type="continuous"><parent link="wheel_rr"/><child link="wheel_rr_roller_4"/><origin xyz="0.0133388 0 -0.036648" rpy="-1.90034 -0.726775 0.977781"/><axis xyz="0 0 1"/><limit lower="-1e+09" upper="1e+09" effort="0" velocity="200"/><dynamics damping="0.0005" friction="0"/></joint>
  <link name="wheel_rr_roller_5">
    <inertial><origin xyz="0 0 0" rpy="0 0 0"/><mass value="0.012"/>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</inertial>
    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
  </link>
  <joint name="wheel_rr_roller_5_joint" type="continuous"><parent link="wheel_rr"/><child link="wheel_rr_roller_5"/><origin xyz="-0.0133388 0 -0.036648" rpy="-1.24125 -0.726775 0.530853"/><axis xyz="0 0 1"/><limit lower="-1e+09" upper="1e+09" effort="0" velocity="200"/><dynamics damping="0.0005" friction="0"/></joint>
  <link name="wheel_rr_roller_6">
    <inertial><origin xyz="0 0 0" rpy="0 0 0"/><mass value="0.012"/>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</inertial>
    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
  </link>
  <joint name="wheel_rr_roller_6_joint" type="continuous"><parent link="wheel_rr"/><child link="wheel_rr_roller_6"/><origin xyz="-0.033775 0 -0.0195" rpy="-0.857072 -0.361367 0.166525"/><axis xyz="0 0 1"/><limit lower="-1e+09" upper="1e+09" effort="0" velocity="200"/><dynamics damping="0.0005" friction="0"/></joint>
  <link name="wheel_rr_roller_7">
    <inertial><origin xyz="0 0 0" rpy="0 0 0"/><mass value="0.012"/>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</inertial>
    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
  </link>
  <joint name="wheel_rr_roller_7_joint" type="continuous"><parent link="wheel_rr"/><child link="wheel_rr_roller_7"/><origin xyz="-0.0384075 0 0.00677228" rpy="-0.793052 0.123098 -0.0515956"/><axis xyz="0 0 1"/><limit lower="-1e+09" upper="1e+09" effort="0" velocity="200"/><dynamics damping="0.0005" friction="0"/></joint>
  <link name="wheel_rr_roller_8">
    <inertial><origin xyz="0 0 0" rpy="0 0 0"/><mass value="0.012"/>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</inertial>
    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
  </link>
  <joint name="wheel_rr_roller_8_joint" type="continuous"><parent link="wheel_rr"/><child link="wheel_rr_roller_8"/><origin xyz="-0.0250687 0 0.0298757" rpy="-0.999508 0.572429 -0.318636"/><axis xyz="0 0 1"/><limit lower="-1e+09" upper="1e+09" effort="0" velocity="200"/><dynamics damping="0.0005" friction="0"/></joint>
  <link name="lidar_link">
    <inertial><origin xyz="0 0 0" rpy="0 0 0"/><mass value="0.17"/>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</inertial>
    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
  </link>
  <joint name="lidar_fixed" type="fixed"><parent link="base_link"/><child link="lidar_link"/><origin xyz="0.04 0 0.165" rpy="0 0 0"/></joint>
  <link name="tote">
    <inertial><origin xyz="0 0 0.04" rpy="0 0 0"/><mass value="1.05"/>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</inertial>
    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
  </link>
  <joint name="tote_fixed" type="fixed"><parent link="base_link"/><child link="tote"/><origin xyz="-0.07 0 0.256" rpy="0 0 0"/></joint>
  <link name="column">
    <inertial><origin xyz="-0.000837434 3.71592e-06 0.315898" rpy="0 0 0"/><mass value="3.6588"/>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</inertial>
    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
  </link>
  <joint name="column_fixed" type="fixed"><parent link="base_link"/><child link="column"/><origin xyz="0.18 0 0.313" rpy="0 0 0"/></joint>
  <link name="top_beam">
    <inertial><origin xyz="-0.00486948 1.81726e-06 0.00558039" rpy="0 0 0"/><mass value="0.1456"/>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</inertial>
    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
  </link>
  <joint name="top_beam_fixed" type="fixed"><parent link="base_link"/><child link="top_beam"/><origin xyz="0.18 0 1.313" rpy="0 0 0"/></joint>
  <link name="estop">
    <inertial><origin xyz="0 0 0" rpy="0 0 0"/><mass value="0.03"/>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</inertial>
    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
  </link>
  <joint name="estop_fixed" type="fixed"><parent link="top_beam"/><child link="estop"/><origin xyz="-0.005 0 0.022" rpy="0 0 0"/></joint>
  <link name="carriage">
    <inertial><origin xyz="-0.00141969 0.00012524 -0.0155363" rpy="0 0 0"/><mass value="0.79799"/>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</inertial>
    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
  </link>
  <joint name="lift" type="prismatic"><parent link="base_link"/><child link="carriage"/><origin xyz="0.18 0 0.42" rpy="0 0 0"/><axis xyz="0 0 1"/><limit lower="0" upper="0.871" effort="300" velocity="0.1"/><dynamics damping="50" friction="5"/></joint>
  <link name="camera_mast">
    <inertial><origin xyz="0.06425 0 0.151875" rpy="0 0 0"/><mass value="0.12"/>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</inertial>
    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
  </link>
  <joint name="camera_mast_fixed" type="fixed"><parent link="carriage"/><child link="camera_mast"/><origin xyz="0 0 0" rpy="0 0 0"/></joint>
  <link name="scene_camera">
    <inertial><origin xyz="0 0 0" rpy="0 0 0"/><mass value="0.07"/>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</inertial>
    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
  </link>
  <joint name="scene_camera_fixed" type="fixed"><parent link="camera_mast"/><child link="scene_camera"/><origin xyz="0.14 0 0.19" rpy="0 0.95 0"/></joint>
  <link name="scene_camera_optical">
    <inertial><origin xyz="0 0 0" rpy="0 0 0"/><mass value="0.001"/>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</inertial>
  </link>
  <joint name="scene_camera_optical_fixed" type="fixed"><parent link="scene_camera"/><child link="scene_camera_optical"/><origin xyz="0.016 0 0" rpy="-1.5708 0 -1.5708"/></joint>
  <link name="left_base">
    <inertial><origin xyz="-0.0220782 -2.39973e-05 -0.000918396" rpy="0 0 0"/><mass value="0.381504"/>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</inertial>
    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
  </link>
  <link name="left_upper_arm">
    <inertial><origin xyz="0.096666 1.35736e-10 0.00235275" rpy="0 0 0"/><mass value="0.388809"/>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</inertial>
    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
  </link>
  <link name="left_forearm">
    <inertial><origin xyz="0.096666 1.35736e-10 0.00235275" rpy="0 0 0"/><mass value="0.388809"/>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</inertial>
    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
  </link>
  <link name="left_wrist">
    <inertial><origin xyz="0.0356979 -0.00186178 -0.0500575" rpy="0 0 0"/><mass value="0.368734"/>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</inertial>
    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
  </link>
  <link name="left_tilt">
    <inertial><origin xyz="0.0570896 -0.000750694 0.0206575" rpy="0 0 0"/><mass value="0.250868"/>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</inertial>
    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
  </link>
  <link name="left_hand">
    <inertial><origin xyz="0.0615196 -3.59642e-10 0.0201532" rpy="0 0 0"/><mass value="0.200257"/>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</inertial>
    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
  </link>
  <link name="left_finger_right">
    <inertial><origin xyz="0.0899034 0.0134637 0.0180746" rpy="0 0 0"/><mass value="0.0575955"/>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</inertial>
    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
  </link>
  <link name="left_finger_left">
    <inertial><origin xyz="0.0899034 -0.0134637 0.0199944" rpy="0 0 0"/><mass value="0.0575955"/>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</inertial>
    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
  </link>
  <joint name="left_shoulder_pan" type="revolute"><parent link="left_base"/><child link="left_upper_arm"/><origin xyz="0 0 0" rpy="0 0 0"/><axis xyz="0 0 1"/><limit lower="-2.00713" upper="2.00713" effort="1.9" velocity="4.7"/><dynamics damping="0.05" friction="0.02"/></joint>
  <joint name="left_elbow_pan" type="revolute"><parent link="left_upper_arm"/><child link="left_forearm"/><origin xyz="0.13 0 0" rpy="0 0 0"/><axis xyz="0 0 1"/><limit lower="-2.18166" upper="2.18166" effort="1.9" velocity="4.7"/><dynamics damping="0.05" friction="0.02"/></joint>
  <joint name="left_wrist_pan" type="revolute"><parent link="left_forearm"/><child link="left_wrist"/><origin xyz="0.13 0 0" rpy="0 0 0"/><axis xyz="0 0 1"/><limit lower="-2.1293" upper="2.1293" effort="1.9" velocity="4.7"/><dynamics damping="0.05" friction="0.02"/></joint>
  <joint name="left_wrist_pitch" type="revolute"><parent link="left_wrist"/><child link="left_tilt"/><origin xyz="0.04 0 -0.0746" rpy="0 0 0"/><axis xyz="0 1 0"/><limit lower="-0.261799" upper="2.00713" effort="1.9" velocity="4.7"/><dynamics damping="0.05" friction="0.02"/></joint>
  <joint name="left_wrist_roll" type="revolute"><parent link="left_tilt"/><child link="left_hand"/><origin xyz="0.085 0 0" rpy="0 0 0"/><axis xyz="1 0 0"/><limit lower="-2.0944" upper="2.0944" effort="1.9" velocity="4.7"/><dynamics damping="0.05" friction="0.02"/></joint>
  <joint name="left_finger_right" type="prismatic"><parent link="left_hand"/><child link="left_finger_right"/><origin xyz="0 0 0" rpy="0 0 0"/><axis xyz="0 1 0"/><limit lower="0" upper="0.045" effort="80" velocity="0.056"/><dynamics damping="2" friction="0.5"/></joint>
  <joint name="left_finger_left" type="prismatic"><parent link="left_hand"/><child link="left_finger_left"/><origin xyz="0 0 0" rpy="0 0 0"/><axis xyz="0 -1 0"/><limit lower="0" upper="0.045" effort="80" velocity="0.056"/><dynamics damping="2" friction="0.5"/></joint>
  <link name="left_wrist_camera">
    <inertial><origin xyz="0 0 0" rpy="0 0 0"/><mass value="0.001"/>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</inertial>
  </link>
  <joint name="left_wrist_camera_fixed" type="fixed"><parent link="left_tilt"/><child link="left_wrist_camera"/><origin xyz="0.0981064 0 0.100823" rpy="0 0.610865 0"/></joint>
  <link name="left_wrist_camera_optical">
    <inertial><origin xyz="0 0 0" rpy="0 0 0"/><mass value="0.001"/>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</inertial>
  </link>
  <joint name="left_wrist_camera_optical_fixed" type="fixed"><parent link="left_wrist_camera"/><child link="left_wrist_camera_optical"/><origin xyz="0 0 0" rpy="-1.5708 0 -1.5708"/></joint>
  <link name="left_tcp">
    <inertial><origin xyz="0 0 0" rpy="0 0 0"/><mass value="0.001"/>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</inertial>
  </link>
  <joint name="left_tcp_fixed" type="fixed"><parent link="left_hand"/><child link="left_tcp"/><origin xyz="0.13 0 0" rpy="0 0 0"/></joint>
  <link name="right_base">
    <inertial><origin xyz="-0.0220782 -2.39973e-05 -0.000918396" rpy="0 0 0"/><mass value="0.381504"/>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</inertial>
    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
  </link>
  <link name="right_upper_arm">
    <inertial><origin xyz="0.096666 1.35736e-10 0.00235275" rpy="0 0 0"/><mass value="0.388809"/>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</inertial>
    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
  </link>
  <link name="right_forearm">
    <inertial><origin xyz="0.096666 1.35736e-10 0.00235275" rpy="0 0 0"/><mass value="0.388809"/>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</inertial>
    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
  </link>
  <link name="right_wrist">
    <inertial><origin xyz="0.0356979 -0.00186178 -0.0500575" rpy="0 0 0"/><mass value="0.368734"/>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</inertial>
    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
  </link>
  <link name="right_tilt">
    <inertial><origin xyz="0.0570896 -0.000750694 0.0206575" rpy="0 0 0"/><mass value="0.250868"/>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</inertial>
    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
  </link>
  <link name="right_hand">
    <inertial><origin xyz="0.0615196 -3.59642e-10 0.0201532" rpy="0 0 0"/><mass value="0.200257"/>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</inertial>
    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
  </link>
  <link name="right_finger_right">
    <inertial><origin xyz="0.0899034 0.0134637 0.0180746" rpy="0 0 0"/><mass value="0.0575955"/>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</inertial>
    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
  </link>
  <link name="right_finger_left">
    <inertial><origin xyz="0.0899034 -0.0134637 0.0199944" rpy="0 0 0"/><mass value="0.0575955"/>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</inertial>
    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
  </link>
  <joint name="right_shoulder_pan" type="revolute"><parent link="right_base"/><child link="right_upper_arm"/><origin xyz="0 0 0" rpy="0 0 0"/><axis xyz="0 0 1"/><limit lower="-2.00713" upper="2.00713" effort="1.9" velocity="4.7"/><dynamics damping="0.05" friction="0.02"/></joint>
  <joint name="right_elbow_pan" type="revolute"><parent link="right_upper_arm"/><child link="right_forearm"/><origin xyz="0.13 0 0" rpy="0 0 0"/><axis xyz="0 0 1"/><limit lower="-2.18166" upper="2.18166" effort="1.9" velocity="4.7"/><dynamics damping="0.05" friction="0.02"/></joint>
  <joint name="right_wrist_pan" type="revolute"><parent link="right_forearm"/><child link="right_wrist"/><origin xyz="0.13 0 0" rpy="0 0 0"/><axis xyz="0 0 1"/><limit lower="-2.1293" upper="2.1293" effort="1.9" velocity="4.7"/><dynamics damping="0.05" friction="0.02"/></joint>
  <joint name="right_wrist_pitch" type="revolute"><parent link="right_wrist"/><child link="right_tilt"/><origin xyz="0.04 0 -0.0746" rpy="0 0 0"/><axis xyz="0 1 0"/><limit lower="-0.261799" upper="2.00713" effort="1.9" velocity="4.7"/><dynamics damping="0.05" friction="0.02"/></joint>
  <joint name="right_wrist_roll" type="revolute"><parent link="right_tilt"/><child link="right_hand"/><origin xyz="0.085 0 0" rpy="0 0 0"/><axis xyz="1 0 0"/><limit lower="-2.0944" upper="2.0944" effort="1.9" velocity="4.7"/><dynamics damping="0.05" friction="0.02"/></joint>
  <joint name="right_finger_right" type="prismatic"><parent link="right_hand"/><child link="right_finger_right"/><origin xyz="0 0 0" rpy="0 0 0"/><axis xyz="0 1 0"/><limit lower="0" upper="0.045" effort="80" velocity="0.056"/><dynamics damping="2" friction="0.5"/></joint>
  <joint name="right_finger_left" type="prismatic"><parent link="right_hand"/><child link="right_finger_left"/><origin xyz="0 0 0" rpy="0 0 0"/><axis xyz="0 -1 0"/><limit lower="0" upper="0.045" effort="80" velocity="0.056"/><dynamics damping="2" friction="0.5"/></joint>
  <link name="right_wrist_camera">
    <inertial><origin xyz="0 0 0" rpy="0 0 0"/><mass value="0.001"/>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</inertial>
  </link>
  <joint name="right_wrist_camera_fixed" type="fixed"><parent link="right_tilt"/><child link="right_wrist_camera"/><origin xyz="0.0981064 0 0.100823" rpy="0 0.610865 0"/></joint>
  <link name="right_wrist_camera_optical">
    <inertial><origin xyz="0 0 0" rpy="0 0 0"/><mass value="0.001"/>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</inertial>
  </link>
  <joint name="right_wrist_camera_optical_fixed" type="fixed"><parent link="right_wrist_camera"/><child link="right_wrist_camera_optical"/><origin xyz="0 0 0" rpy="-1.5708 0 -1.5708"/></joint>
  <link name="right_tcp">
    <inertial><origin xyz="0 0 0" rpy="0 0 0"/><mass value="0.001"/>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</inertial>
  </link>
  <joint name="right_tcp_fixed" type="fixed"><parent link="right_hand"/><child link="right_tcp"/><origin xyz="0.13 0 0" rpy="0 0 0"/></joint>
  <joint name="left_arm_mount" type="fixed"><parent link="carriage"/><child link="left_base"/><origin xyz="0 0.15 0.0655" rpy="0 0 2.35619"/></joint>
  <joint name="right_arm_mount" type="fixed"><parent link="carriage"/><child link="right_base"/><origin xyz="0 -0.15 0.0655" rpy="0 0 -2.35619"/></joint>
</robot>
