Chanevan317/Mobile-Manipulator-Robot/(commit log)

2026-11-10 Initial commit: mobile manipulator CAD generator, URDFs, meshes and sim scripts
    [01_base.stl, 01_base_top.3mf, 01_base_top.stl, 02_base_bottom.stl, 02_upper_link.stl, 03_fore_link.stl, 03_upper_arm_top.stl, 04_upper_arm_bottom.stl]
2026-11-10 Remove AM-ARM 200 study, move SO100 reference into SCARA_arm_CAD
    [Print_Leader_SO_ARM100_08k_UP_BambuLabA1Mini_part1.STL, Print_Leader_SO_ARM100_08k_UP_BambuLabA1Mini_part2.STL, WaveShare_Mounting_Plate_SO101.stl, mobile_manipulator_am_arm200.urdf]
2026-11-10 Heat-set inserts for the 350-pc kit: M3 x 4/6/8 split per location, 4.3 mm holes, insert test block; remove unused scene.py
    [02_base_bottom.stl, 03_upper_arm_top.stl, 05_forearm_top.stl, 07_wrist_top.stl, 09_pitch_housing_horn.stl, 10_pitch_housing_idler.stl, 11_tilt_fork_horn.stl, 14_roll_yoke_gripper_housing.stl]
2026-11-10 Remove the Bambu Studio project from print_ready_stl (it held the old base bottom)
    [01_base_top.3mf]
2026-11-10 Leader arm v2: hanging STS3215 leader on a stand, 52 mm links, 8 prints, no inserts; FEA fixes (link plates, pitch fork, stand plug)
    [01_base.stl, 01_stand_top.stl, 02_stand_foot.stl, 02_upper_link.stl, 03_fore_link.stl, 03_link1.stl, 04_link2.stl, 04_wrist.stl]
2026-11-10 Mono-arm experiment: one arm on a shoulder ring around the lift column (URDF variant, checks, reach test, one-arm table / shelf / pick-place tasks)
    [mobile_manipulator_prototype_mono_arm.urdf, mobile_manipulator_prototype_mono_arm_ros.urdf, mono_bracket.stl, mono_bracket_c00.stl, mono_bracket_c01.stl, mono_bracket_c02.stl, mono_bracket_c03.stl, mono_gear_ring.stl]
2026-11-11 Mono tasks faster: trapezoid moves, lift moving during swings, settle once the joints stop, TOPP-RA blended motion (smooth_path.py, default; --no_smooth)
2026-11-11 Mono shoulder ring DRAFT: printed two-row ball race (6 mm steel balls), 72/18 gear drive, reversing-loop cable channel, homing magnet, servo board mount on the carriage; ported into the mono URDF (sh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
    [M01_mono_upper_arm_bottom.stl, M02_mono_upper_arm_top.stl, M03_ring_base.stl, M04_clamp_ring.stl, M05_rotor_bottom.stl, M06_rotor_middle.stl, M07_rotor_top.stl, M08_cable_tray.stl]
2026-11-11 Mono ring bench rig: lift stand-in foot + test lever, 8 tests (smoothness, play, tipping load, backlash, multi-turn, homing, cable loop, drive under load)
    [R01_rig_foot.stl, R02_test_lever.stl, rig_parts.csv]
2026-11-11 Leader arm v3: 0.7-scale copy of the follower (forks, 91 mm links), one arm module with swappable mono / prototype bases, pinch gripper with finger loops, forearm handle for the second hand
    [01_shoulder_mount.stl, 01_stand_top.stl, 02_link1.stl, 02_stand_foot.stl, 03_link1.stl, 03_link2.stl, 04_forearm_handle.stl, 04_link2.stl]
2026-11-11 Leader v3 gripper rework: servo body forward for a 73 mm lever, blades closing to 2 mm, 58 x 24 loops (span 38 -> 84 mm); forearm handle removed
    [03_link2.stl, 04_forearm_handle.stl, 04_wrist.stl, 05_pitch_fork.stl, 06_gripper_frame.stl, 07_gripper_base.stl, 07_gripper_fixed_jaw.stl, 08_gripper_jaw.stl]
2026-11-11 Lift joystick case (draft): KY-023 thumbstick + Raspberry Pi Pico, front-back slot lid; KY-023 dimensions assumed
    [S1_stick_case.stl, S2_stick_lid.stl, boards_assumed.stl, parts.csv]
2026-11-11 Lift joystick: handheld wedge case (tray + rounded top shell, screws from underneath), table placement 40 cm from the leader, preview with a hand
    [S1_stick_case.stl, S1_stick_tray.stl, S2_stick_lid.stl, S2_stick_top.stl, boards_assumed.stl, parts.csv]
2026-11-11 Dual tasks faster (trapezoid moves, settle once the joints stop): table 93 -> 76 s, shelf 90 -> 66 s; robot previews for both layouts (render_robot.py)
2026-11-12 Stationary mono task fixed: scene camera hit the table (edge 0.30 -> 0.36, spots at x 0.40), 7/7 in 48.7 s; lift settle threshold STILL_V_LIFT; optional --slow_carry swings, slip report, MONO_DEBUG c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
2026-11-12 Leader arm: M5 nut pockets under the feet (M5 x 12 ends flush), pedestal M5s in fasteners.csv, horn screw count 32 in the README
    [10_mono_foot.stl, 11_proto_foot_left.stl, 12_proto_foot_right.stl, fasteners.csv, mono_foot.stl, printed_parts.csv, proto_foot_left.stl, proto_foot_right.stl]
2026-11-12 All CAD exports in one folder: CAD/ with SCARA_arm (SO-100 reference files in SCARA_arm/SO100), mono_ring_draft, leader_arm, lift_stick; generator defaults and README paths updated
    [01_base_top.stl, 01_shoulder_mount.stl, 02_base_bottom.stl, 02_link1.stl, 03_link2.stl, 03_upper_arm_top.stl, 04_upper_arm_bottom.stl, 04_wrist.stl]
2026-11-12 Leader: shoulder support ring + end stop, room for every servo plug, cable routing with clips, board dovetail on the pedestal (leader_cables.py checks all of it); lift controller grip: slide-in Pico 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
    [01_shoulder_mount.stl, 02_link1.stl, 03_link2.stl, 04_wrist.stl, 05_pitch_fork.stl, 06_gripper_frame.stl, 09_pedestal.stl, 11_proto_foot_left.stl]
2026-11-13 Mono ring: arm root collar round the rotor (6 radial M3) replaces the lug, tray screw height fixed, bench rig lever with the same collar, URDF regenerated; clean print meshes in every exporter (no no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
    [01_base_top.stl, 01_shoulder_mount.stl, 02_base_bottom.stl, 02_link1.stl, 03_link2.stl, 03_upper_arm_top.stl, 04_upper_arm_bottom.stl, 04_wrist.stl]
2026-11-13 Real C-Beam XLarge 1000 mm lift from the kit STEP (cbeam_import.py): beam, end mounts, NEMA 23 at the bottom, gantry plate 1.5 mm off the beam, V-wheels, nut block; travel 0.871 m (mono 0.81); camera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
    [M12_gantry_bracket.stl, R01_rig_foot.stl, beam.stl, carriage.stl, cbeam_beam.stl, cbeam_carriage.stl, cbeam_column_hw.stl, cbeam_motor.stl]
2026-11-13 Mono ring layout B (no longer a draft): the arm's own base on a PETG rotor shelf, 2 x 6820-2RS bearings, hub bolts into a 12 mm L bracket; URDF port (ring + base shoulder 161 mm out + one link), IK g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
    [14_roll_yoke_gripper_housing.stl, M01_mono_upper_arm_bottom.stl, M01_ring_base.stl, M02_inner_spacer.stl, M02_mono_upper_arm_top.stl, M03_clamp_ring.stl, M03_ring_base.stl, M04_clamp_ring.stl]
2026-11-13 Dual-arm holder: printed PETG frame around the beam for both arm bases (two halves, lap joints, legs through the gantry plate holes), scene camera post moved into its socket; URDF carriage uses it; t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
    [D01_holder_left.stl, D02_holder_right.stl, arm_bases_01_02.stl, camera_post.stl, dual_holder_left.stl, dual_holder_left_c00.stl, dual_holder_left_c01.stl, dual_holder_left_c02.stl]
